ManiRaj129/Simple_Robot/Hardware/Protyping/Prototype Pics/prototype_side.jpeg

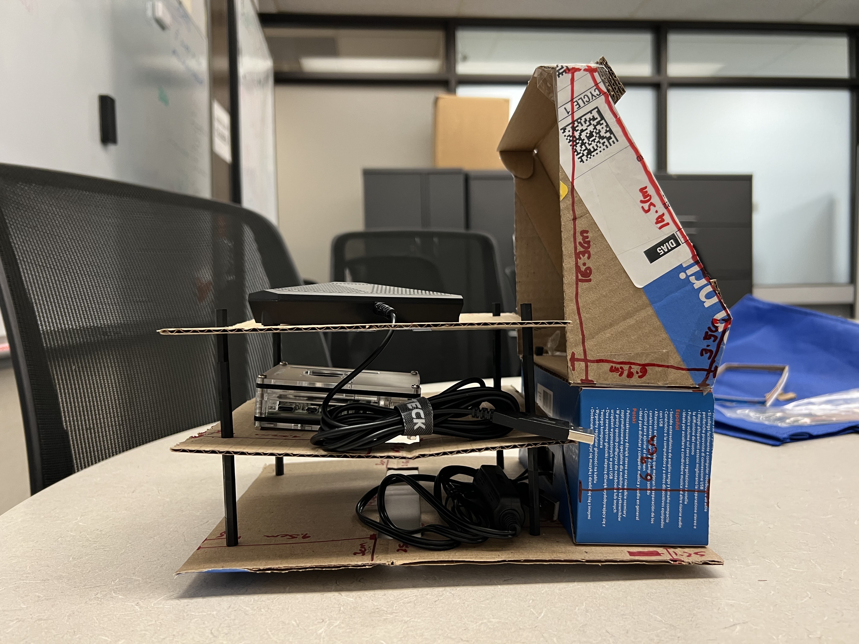
Hardware/Protyping/Prototype Pics/prototype_side.jpeg
