ManiRaj129/Simple_Robot/Hardware/Protyping/Prototype Pics/IMG_2715.jpeg

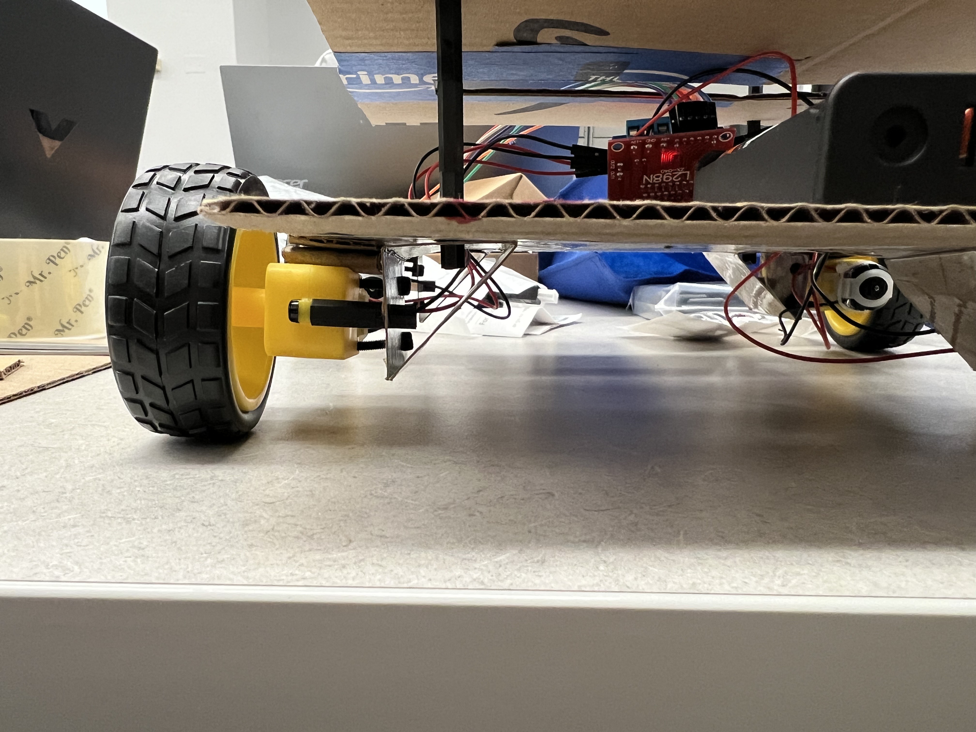
Hardware/Protyping/Prototype Pics/IMG_2715.jpeg
