ManiRaj129/Simple_Robot/Hardware/Protyping/Prototype Pics/prototype_front.jpeg

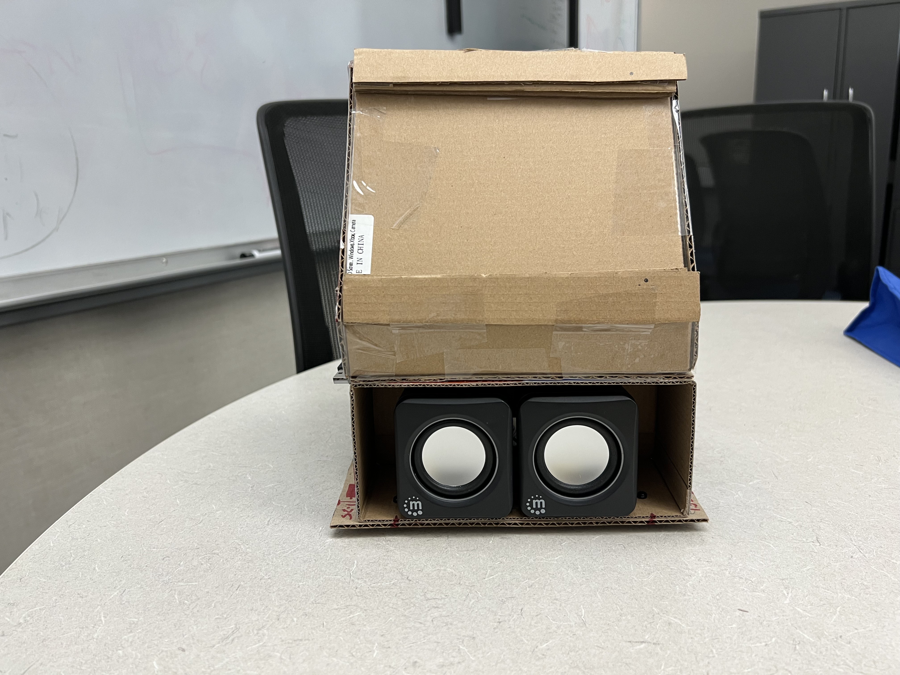
Hardware/Protyping/Prototype Pics/prototype_front.jpeg
