ManiRaj129/Simple_Robot/Hardware/Protyping/Prototype Pics/prototype_motor_attachment_B.jpeg

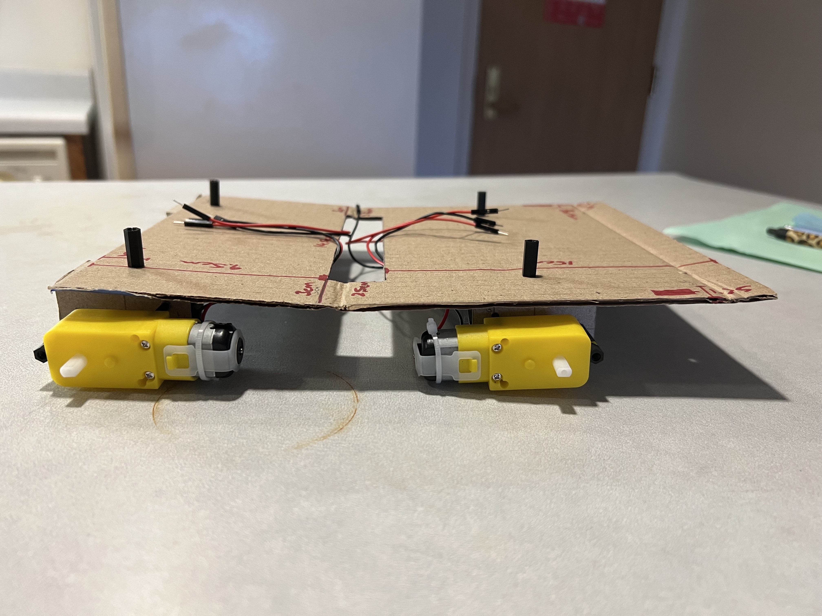
Hardware/Protyping/Prototype Pics/prototype_motor_attachment_B.jpeg
