ManiRaj129/Simple_Robot/Hardware/Protyping/Prototype Pics/prototype_motor_attachment_D.jpeg

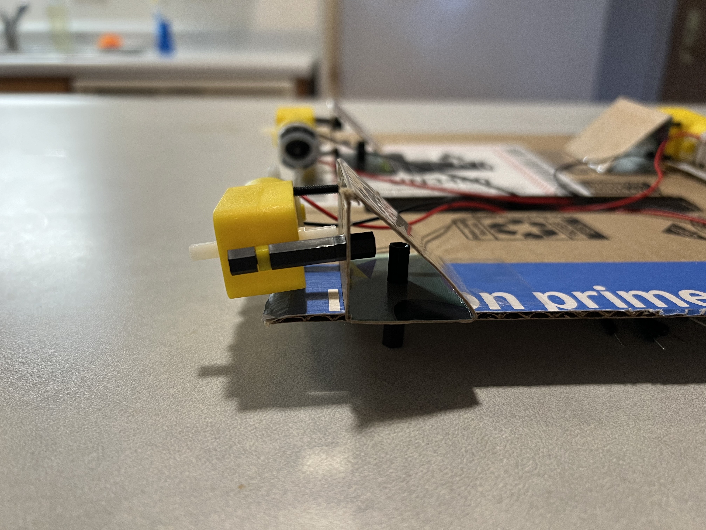
Hardware/Protyping/Prototype Pics/prototype_motor_attachment_D.jpeg
