ManiRaj129/Simple_Robot/Website/frontend/src/assets/flowchat1.png

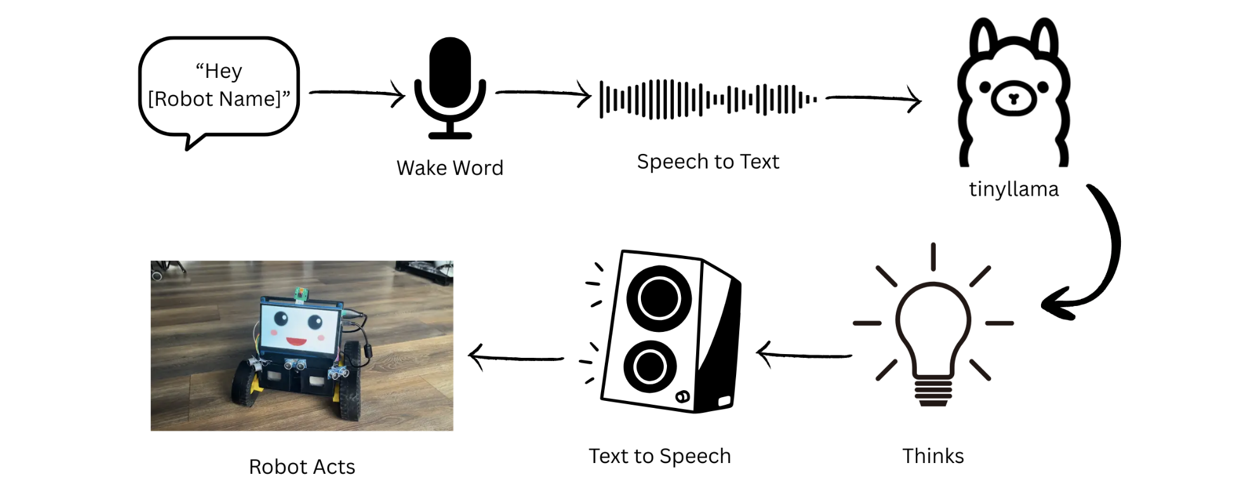
Website/frontend/src/assets/flowchat1.png
