ManiRaj129/Simple_Robot/Hardware/Ordering/Simple Robot Components List - Sheet1.pdf

Component | Name | Weight | Price | Link | Total
Tires 4pcs | Aediko | 116g~ | $8.69 | https://www.amazon.com/AEDIKO-Motor-Gearbox-Shaft-200RPM/dp/B099Z85573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
2C124&sr=8-2 (https://www.amazon.com/AEDIKO-Motor-Gearbox-Shaft-200RPM/dp/B099Z85573) | $147.91
Motor Driver | L298N | 55g | $6.98 | https://www.amazon.com/WWZMDiB-L298N-H-Bridge-Controller-Raspberry/dp/B0CR6BX5QL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 (https://www.amazon.com/WWZMDiB-L298N-H-Bridge-Controller-Raspberry/dp/B0CR6BX5QL)
7 inch HDMI Display | CUQI 7 | 340g | $33.59 | https://www.amazon.com/CUQI-1024x600-Display-Monitor-Raspberry/dp/B0D6YTVNCW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 (https://www.amazon.com/CUQI-1024x600-Display-Monitor-Raspberry/dp/B0D6YTVNCW)
Omnidirectional Microphone | Cmteck | 173g | $14.24 | https://www.amazon.com/CMTECK-Microphone-Indicator-Omnidirectional-Conference/dp/B075HTKBNP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 (https://www.amazon.com/CMTECK-Microphone-Indicator-Omnidirectional-Conference/dp/B075HTKBNP)
USB Speakers | Manhattan | 289g | $9.99 | https://www.amazon.com/MANHATTAN-2600-Speaker-System-161435/dp/B0979MFHZ3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 (https://www.amazon.com/MANHATTAN-2600-Speaker-System-161435/dp/B0979MFHZ3?xpid=vOo4po_baICN7)
Jumper Cables (20cm Female to Female) | Antrader | ~ | $5.29 | https://www.amazon.com/Antrader-Breadboard-Dupont-Arduino-Raspberry/dp/B07RXK9SLW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

hcSJOrnVKkTcKfu4ulswElwjKT7RAEeGEU1_zdANiLYmyvPi2Irr_QbltHb568RdM. K7CGSYfpMGXnlLfVMGWdFpJqJcADAkCSh4Of7N4xtls&dib_tag=se&keywords=jumper%2Bcables%2Bfor%2Braspberry% 2Bpi&qid=1757024692&sprefix=jumper%2Bcables%2Bfor%2Bras%2Caps%2C171&sr=8-5&th=1 (https://www.amazon.com/Antrader-Breadboard-Dupont-Arduino-Raspberry/dp/B07S2RH6Q4)
Standoff Screws | Ladinka | ~ | $7.29 | https://www.amazon.com/Black-Nylon-Standoff-Spacers-Screws/dp/B0F297R23T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 (https://www.amazon.com/Black-Nylon-Standoff-Spacers-Screws/dp/B0F297R23T)
5V Power Bank | Jonkuu | 181g | $9.99 | https://www.amazon.com/JONKUU-Portable-10000mAh-Powerpack-Compatible/dp/B07TT2VGT6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 (https://www.amazon.com/JONKUU-Portable-10000mAh-Powerpack-Compatible/dp/B07TT2VGT6)

7.4V Battery
Pack + Charger
EcoSolutions | 144g | $19.89 | https://www.amazon.com/Universal-Rechargeable-Batteries-Flashlight-Headlamp/dp/B0CMQL6S7G/ref=sr_1_17? crid=DWNGPACEMD9S&dib=eyJ2IjoiMSJ9.vgIiPB31UA3Lxdx088dF4s2uJaExMm_- zCLCKHxfqNNwJn_5lhiHqZegqqy9xEM3Y9k4YiTJGwZSqkNAD51nmreGx4kWuaAom1DFJsecH5JGD5UHtGjHj5SFwjIUMsAye0- gxWf83qtBZFj3eMFTjZEpFjDG5sp94Tp0mUHG_IVHebzq23sPdLi_lwyfarhKRFwY8eIv1DA-jQNLcAAW52LQWAdIgw- oboDdc7qcrTkl6MF7_Urx59OsdGap9AmAxDOzpsA9D0333KTEBNDTMGIklnQL0fMgNcdj4wUzrD4.Uup-JRwJ4- YdD80XzTOioevjtJ9W4b8HeOzOsTmsn68&dib_tag=se&keywords=18650+Rechargeable+Battery&qid=1757026378&sprefix=%2Caps% 2C198&sr=8-17 (https://www.amazon.com/Universal-Rechargeable-Batteries-Flashlight-Headlamp/dp/B0CMQL6S7G)
Pi Camera | Arducam | 9g | $6.99 | https://www.amazon.com/Arducam-Megapixels-Sensor-OV5647-Raspberry/dp/B012V1HEP4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 (https://www.amazon.com/Arducam-Megapixels-Sensor-OV5647-Raspberry/dp/B012V1HEP4)
Ultrasonic Sensors | Elegoo | 27g~ | $8.99 | https://www.amazon.com/ELEGOO-HC-SR04-Ultrasonic-Distance-MEGA2560/dp/B01COSN7O6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 (https://www.amazon.com/ELEGOO-HC-SR04-Ultrasonic-Distance-MEGA2560/dp/B01COSN7O6)
Battery Holder | Aokin | 50g | $5.99 | https://www.amazon.com/Aokin-Battery-Storage-Parallel-Batteries/dp/B07Q13T3RH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 (https://www.amazon.com/Aokin-Battery-Storage-Parallel-Batteries/dp/B07Q13T3RH)

Raspberry Pi
Storage
(MicroSD Micro)
SanDisk | 5g | $9.99 | https://www.amazon.com/SanDisk-128GB-microSDXC-Memory-Adapter/dp/B0B7NXBM6P/ref=sr_1_1? crid=38NI01H1AK60X&dib=eyJ2IjoiMSJ9.vIQltjQ_392YQU9uq2zFc1xKPL6XTIaH4nldgh43IuJMVPa32H6AEiA- NTzewaJvV4VboTKGvh0l_ZuZpbogkqc2n4dxLv0ugTQxEgHAon0TRYLDfLxVuklf0Jr3HTXMBvPw3jrAIvJ7GgYqY1Ti79BCImpSn_Z4STpZRl 1Wx_0O7xUIo0o0HjOPZikWEfgIJBeeZFjAWZeL0ty3q1lbf7ra2O21y9X3J-1vsDG7d2A.2UctI6GRZ9- QLvqYH_HmIa93xS2D65LcfAA8RkZNec4&dib_tag=se&keywords=SanDisk%2BUltra%2B128GB%2BmicroSD% 2BCard&qid=1757375346&sprefix=sandisk%2Bultra%2B128gb%2Bmicrosd%2Bcard%2Caps%2C243&sr=8-1&th=1 (https://www.amazon.com/SanDisk-128GB-microSDXC-Memory-Adapter/dp/B0B7NXBM6P)
Raspberry Pi | Provided

Robot Hardware Guide
https://www.youtube.com/watch?v=IT1uBUsOmUY

Robot Software Guide
https://www.youtube.com/post/UgkxLFsSsbe84d-EnNY3vbEQ3SufXlb_aLKC (https://www.youtube.com/post/UgkxLFsSsbe84d-EnNY3vbEQ3SufXlb_aLKC)
