ManiRaj129/Simple_Robot/Hardware/3D Printing Models/Robot - Front.3mf

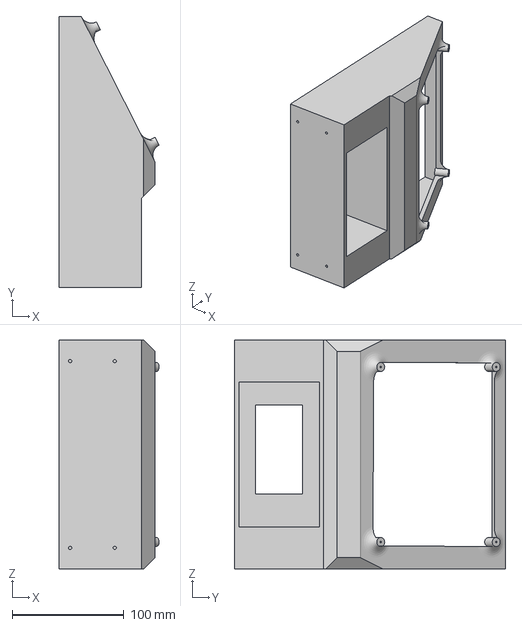
[picture p17: CAD file, 2025-12-18]
Hardware/3D Printing Models/Robot - Front.3mf
89.7 x 243.0 x 205.0 mm
