ManiRaj129/Simple_Robot/Hardware/3D Printing Models/Robot Base.3mf

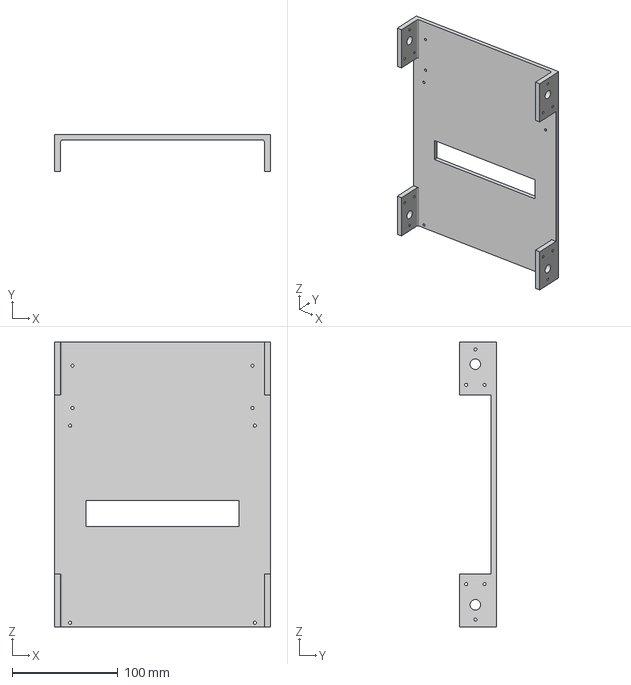
[picture p18: CAD file, 2025-12-18]
Hardware/3D Printing Models/Robot Base.3mf
205.0 x 35.0 x 270.0 mm
