ManiRaj129/Simple_Robot/Hardware/3D Printing Models/Robot - Middle.3mf

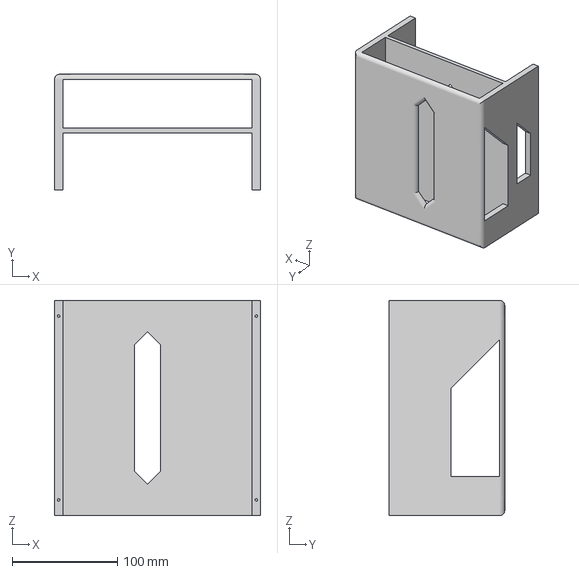
[picture p19: CAD file, 2025-12-18]
Hardware/3D Printing Models/Robot - Middle.3mf
196.0 x 110.0 x 205.0 mm
