ManiRaj129/Simple_Robot/Documents/Robot Operation Flowcharts/Simple Robot  workflow and features .pdf

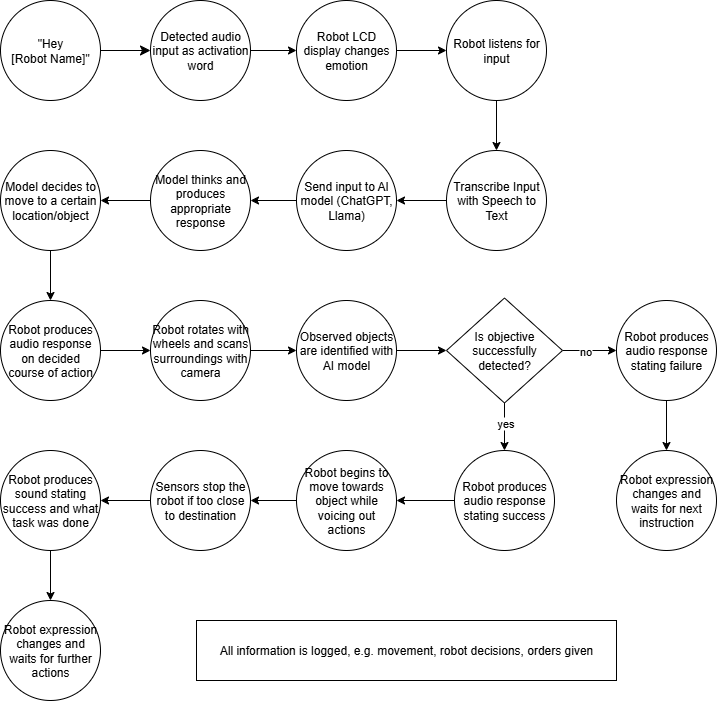
[picture p20: figure]

Models:
Text to Speech
Speech to Text
Generative LLM to answer the questions/ chat Object Detection
