ManiRaj129/Simple_Robot/Hardware/Assembly/RPi - L298N DC Motor Driver Wiring Diagram.drawio.png

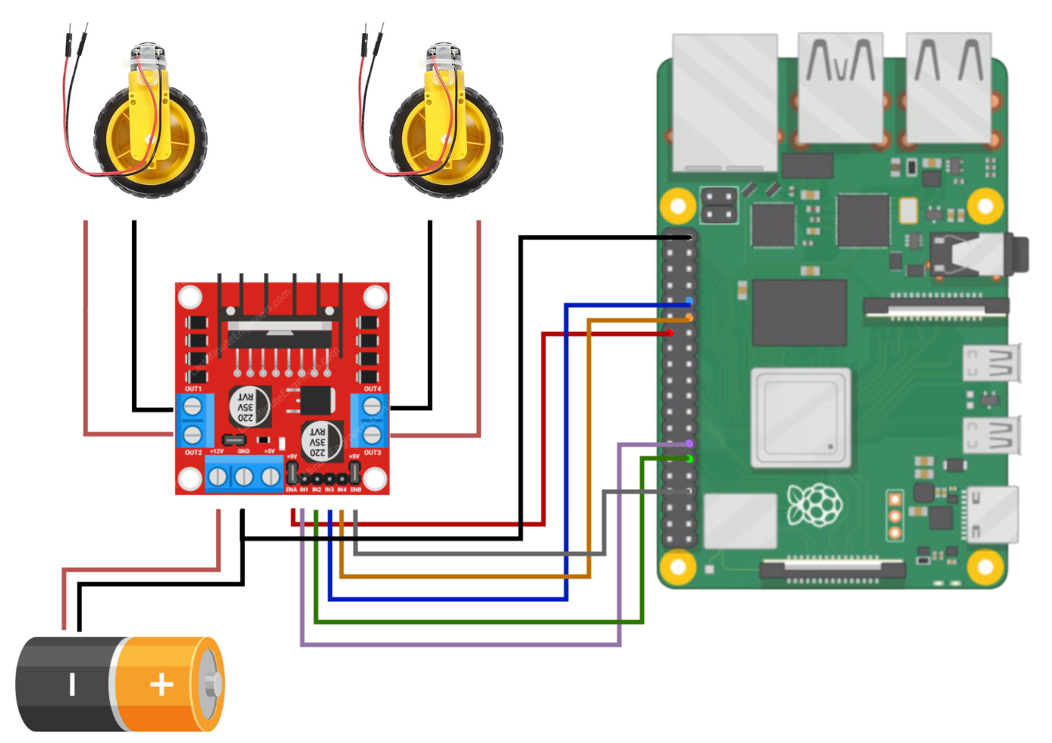
Hardware/Assembly/RPi - L298N DC Motor Driver Wiring Diagram.drawio.png
