ManiRaj129/Simple_Robot/Documents/Robot Operation Flowcharts/Simple Robot Course of Action Flowchart.pdf

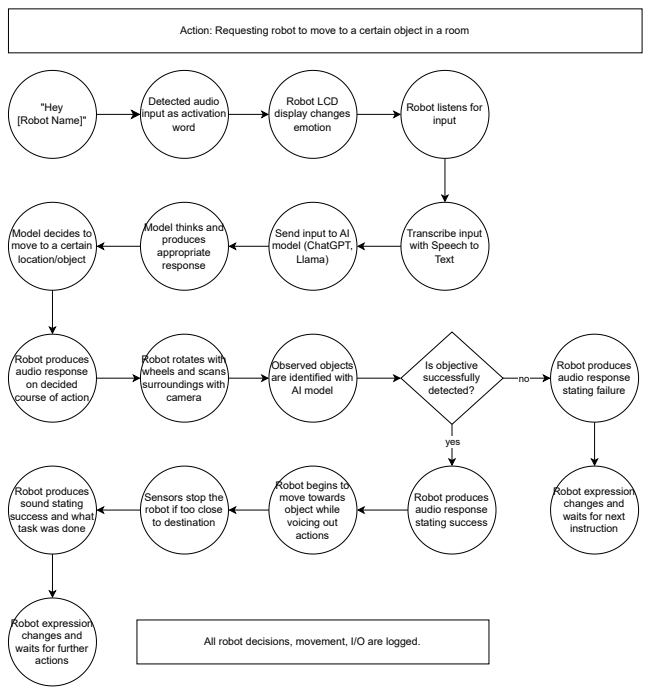
[picture p22: page 1]
"Hey [Robot Name]"; Robot produces audio response stating success; Robot LCD display changes emotion; yes; Is objective successfully detected?; Robot produces audio response stating failure

Action: Requesting robot to move to a certain object in a room

Detected audio
input as activation
word

Robot listens for
input

Model thinks and
produces
appropriate
response

Model decides to
move to a certain
location/object

Send input to AI
model (ChatGPT,
Llama)

Transcribe input
with Speech to
Text

Robot produces
audio response
on decided
course of action

Robot rotates with
wheels and scans
surroundings with
camera

Observed objects
are identified with
AI model

sound stating
success and what
task was done

Robot begins to
move towards
object while
voicing out
actions

Robot expression
changes and
waits for next
instruction

Sensors stop the
robot if too close
to destination

waits for further

All robot decisions, movement, I/O are logged.

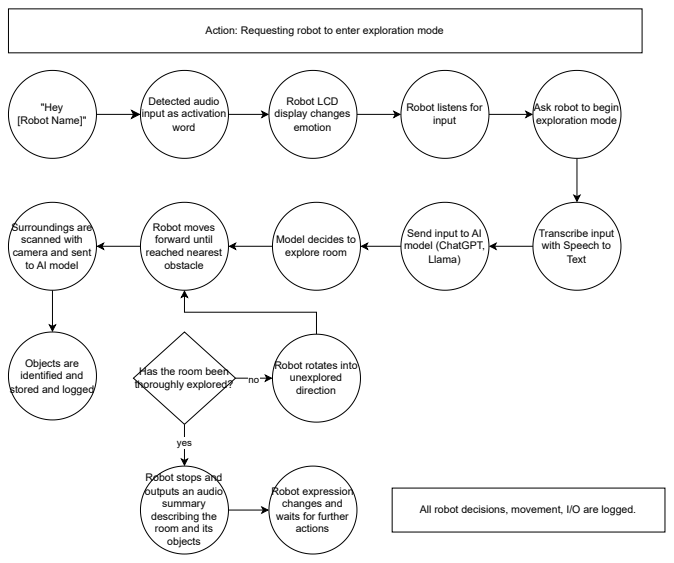
[picture p23: page 2]
"Hey [Robot Name]"; Robot LCD display changes emotion; Robot moves forward until reached nearest obstacle; yes

Action: Requesting robot to enter exploration mode

Detected audio
input as activation
word

Robot listens for
input

Ask robot to begin
exploration mode

Surroundings are
scanned with
camera and sent
to AI model

Model decides to
explore room

Send input to AI
model (ChatGPT,
Llama)

Transcribe input
with Speech to
Text

Objects are
identified and
stored and logged

Robot rotates into
unexplored
direction

Has the room been
thoroughly explored?

Robot stops and
outputs an audio
summary
describing the
room and its
objects

Robot expression
changes and
waits for further
actions

All robot decisions, movement, I/O are logged.
