ManiRaj129/Simple_Robot/Hardware/Protyping/Prototype Pics/prototype_front_box.jpeg

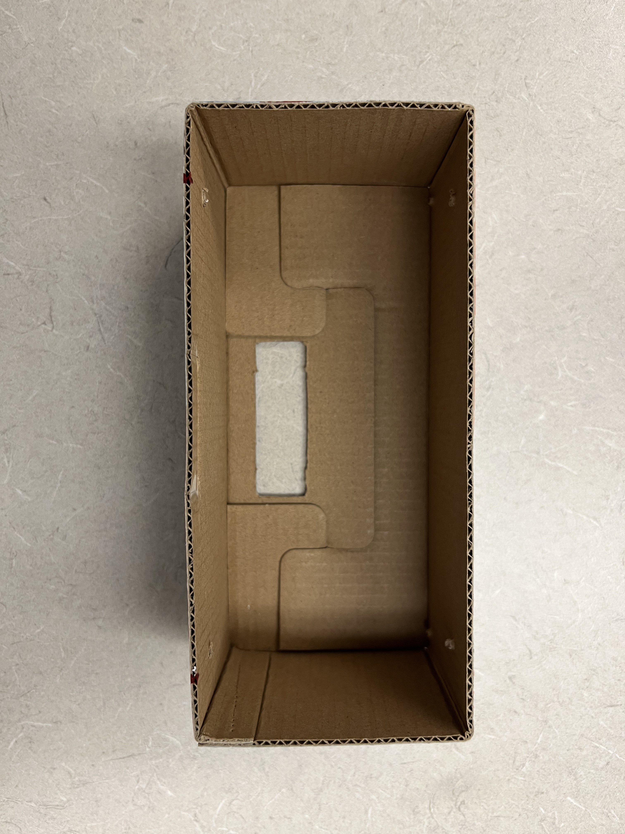
Hardware/Protyping/Prototype Pics/prototype_front_box.jpeg
