ManiRaj129/Simple_Robot/Hardware/Protyping/Prototype Pics/prototype_front_box_2.jpeg

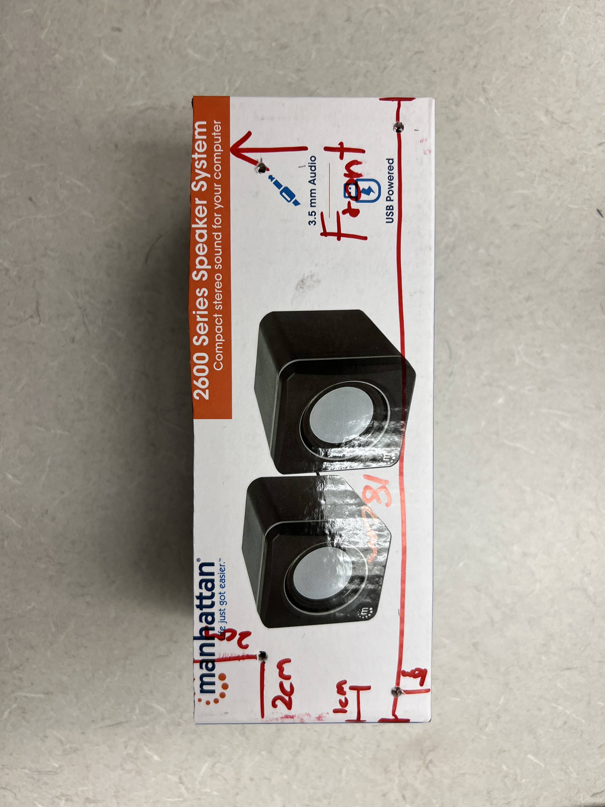
Hardware/Protyping/Prototype Pics/prototype_front_box_2.jpeg
