ManiRaj129/Simple_Robot/Hardware/Protyping/Prototype Pics/prototype_top.jpeg

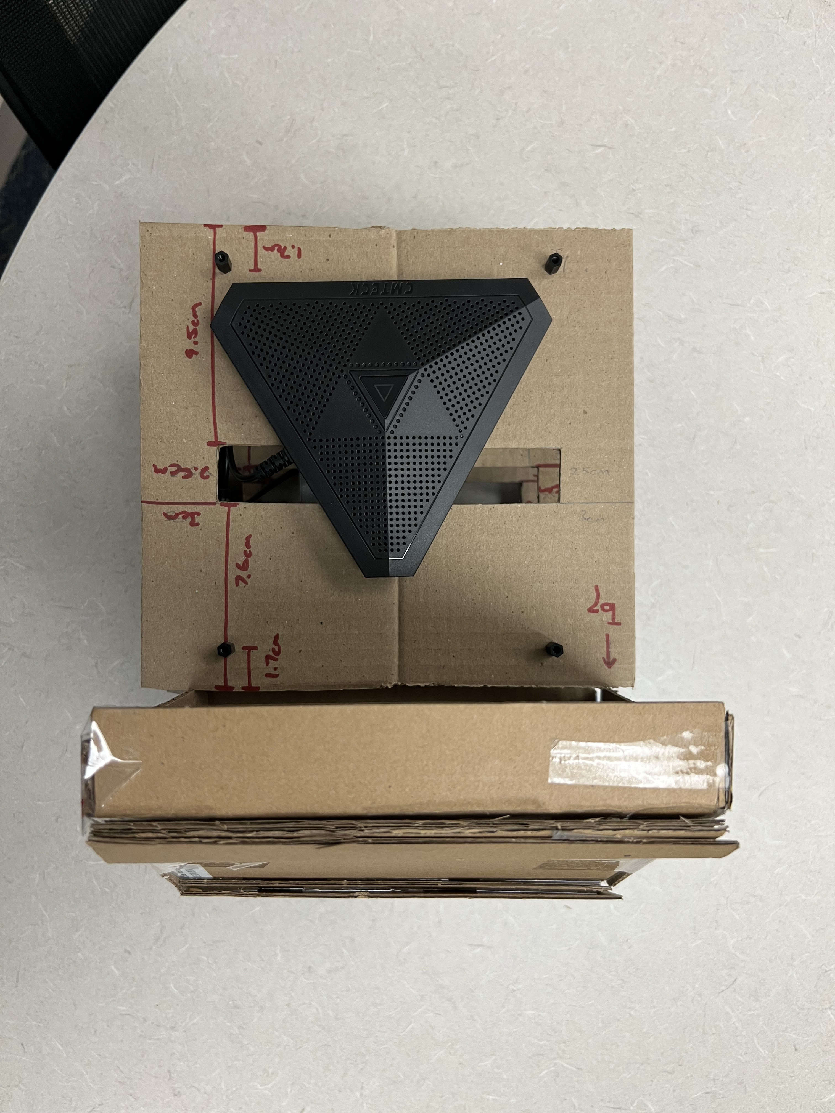
Hardware/Protyping/Prototype Pics/prototype_top.jpeg
