ManiRaj129/Simple_Robot/Hardware/Protyping/Prototype Pics/prototype_top_layer.jpeg

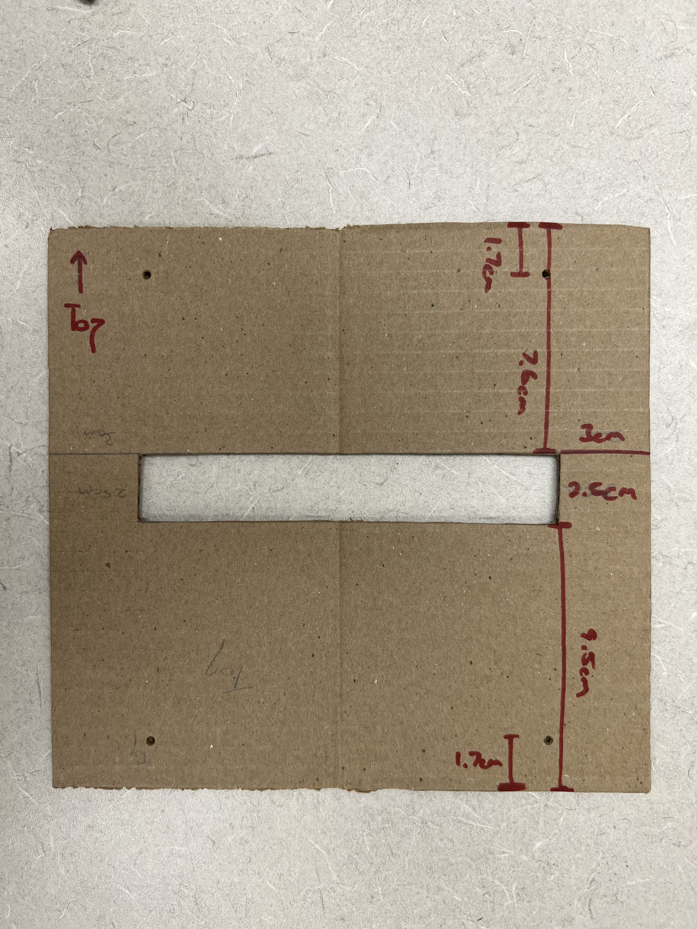
Hardware/Protyping/Prototype Pics/prototype_top_layer.jpeg
